zxs18261/GIM4310-4305/DEMO/硬件资料/软件配置/02_电机参数提取.md

# 02 电机参数提取（GIM4310-10 / GIM4305-10）

> 图片已提取归档至 `图片\` 目录：
> - `图片\电机参数_GIM4310-10.png`（原 `硬件资料\GIM4310-10.png`）
> - `图片\电机参数_GIM4305-10.png`（原 `硬件资料\GIM4305-10.png`）
>
> 下表按图片逐项转录。

---

## 2.1 GIM4310-10 电机参数

| 参数 | 单位 | 数值 |
|---|---|---|
| 额定电压 Rated voltage | V | 48 |
| 电压范围 Voltage range | V | 12~40 |
| 额定功率 Rated power | W | 100.8 |
| 额定扭矩 Rated torque | N·m | 1.91 |
| 堵转扭矩 Peak torque | N·m | 9.23 |
| 减速后额定转速 Rated speed after reduce | rpm | 420.5 |
| 减速后最大转速 Max speed after reduce | rpm | 482.6 |
| 额定电流 Rated current | A | 2.1 |
| 堵转电流 Peak current | A | 15.3 |
| 线电阻 Line resistance | Ω | 1.96 |
| 线电感 Line inductance | mH | 668.47 |
| 转速常数 Speed constant | rpm/V | 10.05 |
| 扭矩常数 Torque constant | N·m/A | 0.78 |
| 极对数 Number of pole pairs | Pairs | 14 |
| 减速比 Gear rate | / | 10:1 |
| 减速器类型 Gear type | / | Planetary |
| 减速器齿轮材料 Reducer gear material | / | STEEL |
| 减速器齿轮背隙 Reducer gear backlash | arcmin | 15 |
| 电机重量不带驱动 Motor weight without driver | g | 217.0 |
| 电机重量带驱动 Motor weight with driver | g | 227.0 |
| 电机尺寸不带驱动 Size without driver | mm | Ø53*32 |
| 电机尺寸带驱动 Size with driver | mm | Ø53*38 |
| 轴向最大负载 Max.Axial load | N | 125 |
| 径向最大负载 Max.Radial load | N | 500 |
| 通信协议 Communication | / | CAN&485 |
| 是否支持单独编码器 Can support separate encoder or not | / | YES |
| 板载编码器精度 Resolution of the encoder on the driver | bit | 14bit |
| 是否支持第二编码器 Second encoder on the output shaft | / | NO |
| 是否支持定制抱闸 Can support custom brakes | / | YES |
| 噪音 Noise | dB | < 60 |
| 防水防尘等级 Protection grade | / | IP54 |
| 工作温度范围 Working temperature | ℃ | -20~+80 |

---

## 2.2 GIM4305-10 电机参数

| 参数 | 单位 | 数值 |
|---|---|---|
| 额定电压 Rated voltage | V | 48 |
| 电压范围 Voltage range | V | 12~40 |
| 额定功率 Rated power | W | 96 |
| 额定扭矩 Rated torque | N·m | 1.01 |
| 堵转扭矩 Peak torque | N·m | 5.61 |
| 减速后额定转速 Rated speed after reduce | rpm | 736.1 |
| 减速后最大转速 Max speed after reduce | rpm | 778.9 |
| 额定电流 Rated current | A | 2.0 |
| 堵转电流 Peak current | A | 19.55 |
| 线电阻 Line resistance | Ω | 1.11 |
| 线电感 Line inductance | mH | 283.96 |
| 转速常数 Speed constant | rpm/V | 16.23 |
| 扭矩常数 Torque constant | N·m/A | 0.5 |
| 极对数 Number of pole pairs | Pairs | 14 |
| 减速比 Gear rate | / | 10:1 |
| 减速器类型 Gear type | / | Planetary |
| 减速器齿轮材料 Reducer gear material | / | ALU or STELL |
| 减速器齿轮背隙 Reducer gear backlash | arcmin | 15 |
| 电机重量不带驱动 Motor weight without driver | g | 140.0 |
| 电机重量带驱动 Motor weight with driver | g | 150.0 |
| 电机尺寸不带驱动 Size without driver | mm | Ø53*26 |
| 电机尺寸带驱动 Size with driver | mm | Ø53*32 |
| 轴向最大负载 Max.Axial load | N | 125 |
| 径向最大负载 Max.Radial load | N | 500 |
| 通信协议 Communication | / | CAN&485 |
| 是否支持单独编码器 Can support separate encoder or not | / | YES |
| 板载编码器精度 Resolution of the encoder on the driver | bit | 14bit |
| 是否支持第二编码器 Second encoder on the output shaft | / | NO |
| 是否支持定制抱闸 Can support custom brakes | / | YES |
| 噪音 Noise | dB | < 60 |
| 防水防尘等级 Protection grade | / | IP54 |
| 工作温度范围 Working temperature | ℃ | -20~+80 |

---

## 2.3 固件使用的关键参数

| 参数 | 取值 | 用途 |
|---|---|---|
| 极对数 Pole pairs | 14 | 电角度 = 机械角 × 14 |
| 编码器分辨率 | 16384（14bit） | MT6701 单圈计数、角度换算 |
| 减速比 Gear rate | 10:1 | 输出轴角度 = 转子角度 / 10 |
| 额定/峰值电流 | GIM4310: 2.1 / 15.3 A；GIM4305: 2.0 / 19.55 A | 电流环限幅、过流保护阈值参考 |
| 线电阻线电感 | GIM4310: 1.96Ω / 668.47mH；GIM4305: 1.11Ω / 283.96mH | 电流环 PI 参数整定（`Kp=Ls·ωc`，`Ki=Rs·ωc·Ts`） |
| 扭矩常数 | GIM4310: 0.78；GIM4305: 0.5 N·m/A | 电流↔转矩换算 |

> 说明：表中“额定电压 48V”与“电压范围 12~40V”为原图数据，可能存在页面标注不一致，
> 实际按母线电压范围设计（设计最大 80V，见原理图注释“额定 24V，设计最大输入 80V”）。
