zxs18261/GIM4310-4305/DEMO/硬件资料/软件配置/README.md

# 软件配置 / 设计文档索引

本目录用于存放 GIM4310 / GIM4305 关节电机控制器（V0.0 板）的硬件资料提取与软件设计文档，
供检查与评审。

| 文档 | 内容 |
|---|---|
| [01_硬件资料提取.md](01_硬件资料提取.md) | 原理图/网表/数据手册提取：引脚分配、功能电路、器件清单、硬件注意事项 |
| [02_电机参数提取.md](02_电机参数提取.md) | GIM4310-10 / GIM4305-10 电机参数（含图片提取归档） |
| [03_软件设计与外设配置.md](03_软件设计与外设配置.md) | 自检例程结构、时钟、外设配置、BSP 接口、编译说明 |
| [04_例程使用说明.md](04_例程使用说明.md) | 硬件连接、上电流程、VOFA+ 设置、逐项验证方法 |
| [05_外设测试手册_VOFA.md](05_外设测试手册_VOFA.md) | ★ 以 VOFA+ 为主的外设测试手册（13 通道、逐项步骤、排查） |
| [06_调试纪要_启动卡死与电流采样.md](06_调试纪要_启动卡死与电流采样.md) | ★ 板级调试纪要：启动卡死（BOOT0/VTOR）、母线电压与电流采样问题定位与修复 |
| `图片/` | 电机参数图片、原理图渲染图 |

代码工程：`DEMO\1、DEMO`（BSP 目录 + 自检 main.c）。

## 关键设计结论（速览）

1. 电流采样使用 **MCU 内部 OPAMP1/2/3** 差分放大，增益按实物 **24**（非原理图标注 25）。
2. MT6701 编码器 **必须软件 SPI**（CSN=PB4 / CLK=PB5 / DO=PB6，无硬件 SPI 复用）。
3. CAN 终端电阻由 **EN_120（PA15）** 控制，120Ω 单独 BSP（`bsp_can.c/.h`）实现。
4. 晶振为 **20MHz**，运行时切 HSE 提升 CAN 时序精度。
5. 参考工程 `1_AxDr_Demo\1.basic代码\5.FOC开环`，本工程在其功能划分基础上按本板硬件重写 BSP。
