zxs18261/GIM4310-4305/DEMO/硬件资料/软件配置/图片/原理图_GIM4310-4305_V1.0.png

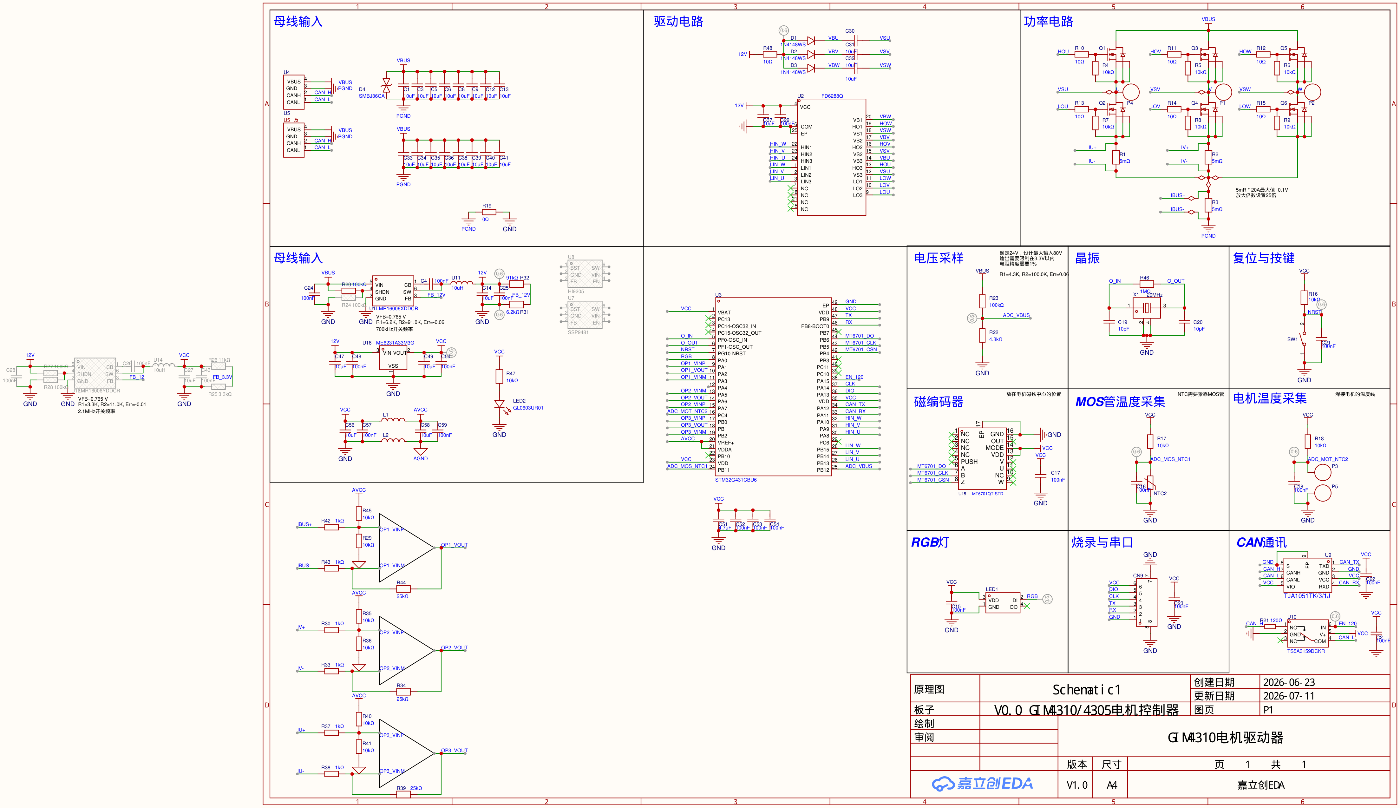
DEMO/硬件资料/软件配置/图片/原理图_GIM4310-4305_V1.0.png
