zxs18261/GIM4310-4305/(list of files, drawings)

Other design files:
SguanFOC库文件编写/SguanFOC_Library-main/上官FOC硬件开源[CH32V3，机器人关节PCB]/Hardware硬件(制板文件和原理图)/【嘉立创】SguanFOC_MOTOR.epro
