zxs18261/GIM4310-4305/SguanFOC库文件编写/GIM4310(V0.0).ioc

Mcu.UserName=STM32G431CBUx
PA0.GPIO_Label=RGB
PA0.Signal=S_TIM2_CH1
PA1.Signal=OPAMP1_VINP
PA10.Signal=S_TIM1_CH3
PA11.Signal=FDCAN1_RX
PA12.Signal=FDCAN1_TX
PA13.Signal=SYS_JTMS-SWDIO
PA14.Signal=SYS_JTCK-SWCLK
PA15.GPIO_Label=EN_120
PA15.Signal=GPIO_Output
PA2.Signal=OPAMP1_VOUT
PA3.Signal=OPAMP1_VINM
PA5.Signal=OPAMP2_VINM
PA6.Signal=OPAMP2_VOUT
PA7.Signal=OPAMP2_VINP
PA8.Signal=S_TIM1_CH1
PA9.Signal=S_TIM1_CH2
PB0.Signal=OPAMP3_VINP
PB1.Signal=OPAMP3_VOUT
PB11.GPIO_Label=ADC_MOS_NTC1
PB11.Signal=ADC1_IN14
PB12.GPIO_Label=ADC_VBUS
PB12.Signal=ADC1_IN11
PB13.Signal=TIM1_CH1N
PB14.Signal=TIM1_CH2N
PB15.Signal=TIM1_CH3N
PB2.Signal=OPAMP3_VINM
PB3.Signal=SPI1_SCK
PB4.Signal=SPI1_MISO
PB5.Signal=SPI1_MOSI
PB8-BOOT0.Signal=USART3_RX
PB9.Signal=USART3_TX
PC11.GPIO_Label=SPI1_CSN
PC11.Signal=GPIO_Output
PC4.GPIO_Label=ADC_MOT_NTC2
PC4.Signal=ADC2_IN5
PF0-OSC_IN.Signal=RCC_OSC_IN
PF1-OSC_OUT.Signal=RCC_OSC_OUT
