zxs18261/GIM4310-4305/SguanFOC库文件编写/Core/Inc/main.h

#define RGB_Pin GPIO_PIN_0
#define RGB_GPIO_Port GPIOA
#define ADC_MOT_NTC2_Pin GPIO_PIN_4
#define ADC_MOT_NTC2_GPIO_Port GPIOC
#define ADC_MOS_NTC1_Pin GPIO_PIN_11
#define ADC_MOS_NTC1_GPIO_Port GPIOB
#define ADC_VBUS_Pin GPIO_PIN_12
#define ADC_VBUS_GPIO_Port GPIOB
#define EN_120_Pin GPIO_PIN_15
#define EN_120_GPIO_Port GPIOA
#define SPI1_CSN_Pin GPIO_PIN_11
#define SPI1_CSN_GPIO_Port GPIOC
