zxs18261/GIM4310-4305/DEMO/1、DEMO/BSP/bsp_clock.h

/**
  ******************************************************************************
  * @file    bsp_clock.h
  * @brief   时钟切换 BSP 头文件（HSI -> HSE 20MHz）
  ******************************************************************************
  */

#ifndef __BSP_CLOCK_H
#define __BSP_CLOCK_H

#ifdef __cplusplus
extern "C" {
#endif

/* Includes ------------------------------------------------------------------*/
#include "main.h"

/* Exported functions prototypes ---------------------------------------------*/
HAL_StatusTypeDef BSP_CLOCK_SwitchToHse(void);
uint8_t           BSP_CLOCK_IsHse(void);

#ifdef __cplusplus
}
#endif

#endif /* __BSP_CLOCK_H */
