zxs18261/GIM4310-4305/(commit log)

2026-07-13 feat: GIM4310/4305 关节电机控制器固件 v0.1.0
    STM32G431CBU6 FOC 固件首版完整实现：
    - 20kHz 电流环（双 ADC 注入组低侧采样）+ SVPWM + 解耦/反电动势/角度前馈
    - 五种控制模式：转矩/转速/位置/MIT 阻抗控制/电压开环
    - 预定位校准（编码器方向、极对数复核、16 点电角偏置）+ Flash 参数持久化
    - CAN 通信（MIT 运控 + 0x600/0x680 配置通道）、120R 终端软件切换
    - 保护体系（过流/贴轨/过欠压/双路 NTC 过温降额/编码器/CAN 超时）
    - WS2812 灯语、串口 shell、CSV 数据流
    - MT6701 位带 SSI 驱动（实物接线 PB4/5/6，硬件 SPI 不可用）
    - Keil AC6 编译 0 Error / 0 Warnin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
    [board_config.h, bsp_adc.c, bsp_adc.h, bsp_can.c, bsp_can.h, bsp_clock.c, bsp_clock.h]
2026-07-13 docs: 重新生成 Doxygen 文档并移除本机快捷方式
    - 重新生成 doc/html（不再包含 .dot 中间文件，精简输出体积）
    - 移除 doc/index.html.lnk（含本机绝对路径的 Windows 快捷方式，不应入库）
2026-08-03 上传本地 GIM4310-4305 工程（手搓与 SguanFOC 库文件编写）
    [【嘉立创】SguanFOC_MOTOR.epro]
2026-08-03 重新上传本地内容：仅保留手搓与 SguanFOC 库文件编写
2026-09-17 新增 SguanFOC库文件编写 CubeMX 工程（Core/Drivers/MDK-ARM）与手搓文档
