zxs18261/GIM4310-4305/(notices)

Notices in the files:
SguanFOC库文件编写/Core/Inc/main.h:
Copyright (c) 2026 STMicroelectronics.
All rights reserved.
This software is licensed under terms that can be found in the LICENSE file
